IowaScaledEngineering/ckt-squeal/doc/squeal-bag-top.odt

Iowa Scaled Engineering, LLC

http://iascaled.com/

Iowa Scaled Engineering, LLC

http://iascaled.com/

Iowa Scaled Engineering, LLC

http://iascaled.com/

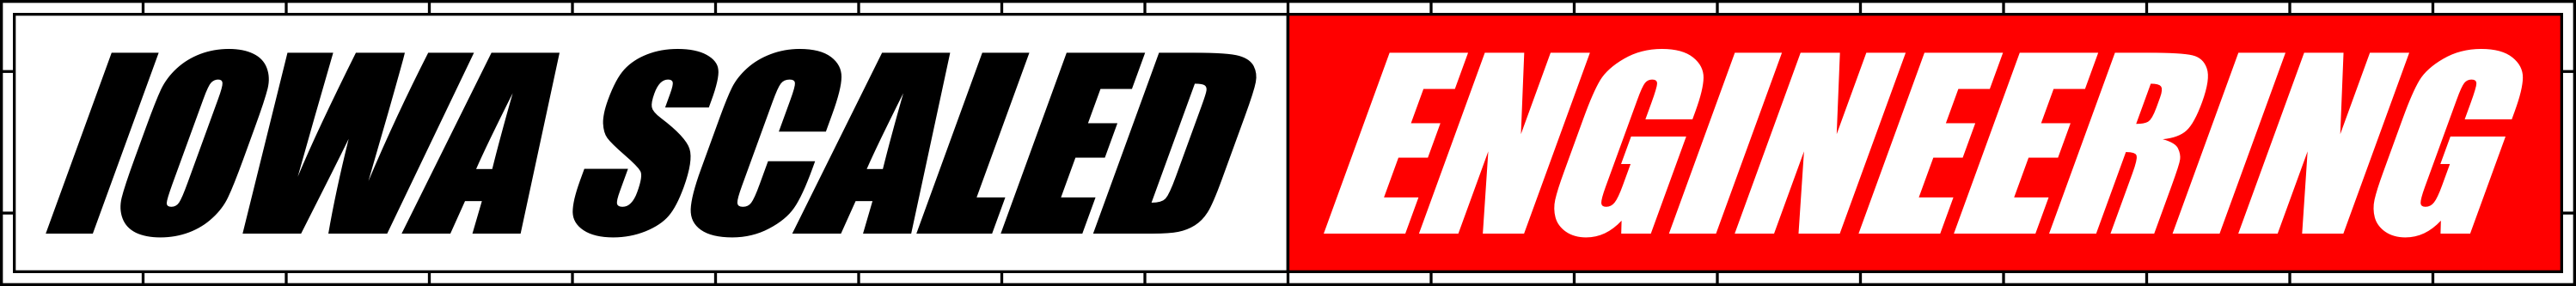
[picture p1: figure]

Low-Cost Sound Player

The CKT-SQUEAL is an inexpensive SD card sound player featuring 4 trigger inputs and reconfigurability via files on the SD card.

CKT-SQUEAL

4GB microSD Card

4GB microSD card for the CKT-SQUEAL sound player.

2” 4Ω Speaker

Speaker for the CKT-SQUEAL sound player.
