IowaScaledEngineering/ckt-squeal/doc/usermanual/ckt-squeal-manual.odt

CKT-SQUEAL v1 User Manual

# Features

- Integrated 725mW speaker driver and volume control
- Trigger inputs for four different groups of sounds
- User-loadable sounds using standard microSD cards and WAV files
- Flexible playback options:
  - Edge or level triggered
  - One-shot, random, or looping playback
  - Begin-middle-end mode
- Cost-effective sound playback for adding ambient sound effects to your layout

# Installation

### Power

The CKT-SQUEAL requires 8-14VDC power. Ripple or electrical noise on the input power may create hums, pops, or buzzing in the audio output, so be sure to use a clean power source. Do not exceed 14VDC or the device may be damaged.

### Inputs

Inputs are triggered by connecting them to the ground terminals provided between trigger inputs SW2 & SW3. The inputs are internally pulled up, so it's possible to trigger them with just a pushbutton or open-drain (aka open-collector) connection to ground.

Figure 1: Examples of input and output connections

Do not apply more than 3.3V to any of the input terminals or they will be damaged. If you want to trigger off another circuit with higher voltages, please use a CKT-MRISO2 to provide isolation.

### Outputs

The speaker outputs from the onboard power amplifier are designed for speakers with an impedance of 4Ω - 16Ω. Lower impedances will provide higher volumes, but will also consume additional power. We recommend 4Ω speakers for best performance. Output volume to the speaker can be adjusted with R9, the large thumbwheel potentiometer located near the speaker outputs.

Additionally, a line level output is provided for those wanting to use external amplification. The holes labeled “J8”, near the programming header and microprocessor, provide line level signals. The audio signal is on pin 1 (the square pad) and ground/shield is on the round pad.

### Diagnostic Lights

The CKT-SQUEAL comes with four indicator lights that show the current status and indicate any problems. Three status lights (D3-D5) are located near the edge of the board. A fourth power indicator (D2) is located next to the microSD card socket.

LED Color | If Solid... | If Blinking...
Red (D5) | Hardware error | SD card not inserted/recognized
Yellow (D4) | Player ready but idle | Reading SD card
Green (D3) | Audio is playing | n/a
Green (D2) | Power is on | Regulator is overheating because of hardware failure or excessive input voltage

# Audio Files and the MicroSD Card

The CKT-SQUEAL can take any microSD or microSDHC card up to 32GB that is formatted as FAT or FAT32 and supports SPI access modes. MicroSDXC cards will not work (generally cards greater than 64GB). However, given the small size of most sound files, even a 1GB card is far more than adequate.

While we have tested with industry-standard cards and strive to support any card that adheres to the standards, we can't guarantee that every brand and model will work - particularly those from the low-cost, no-name bargain vendors. We recommend Sandisk 4GB microSDHC cards for their reliability and compatibility.

The microSD card should have four directories (also known as folders) at the top level. They should be named event1, event2, event3, and event4. These correspond to the sounds that will play for inputs SW1-SW4. If you don't wish to use a given input, there's no need to create a directory/folder for that input.

The sound files you want to play for a given input should be placed into the eventN folder for that input. Sound files should be 16-bit mono WAV files with LPCM encoding. All standard sample rates up to 48kHz are supported. Files should have a suffix of “.wav”.

If you don't already have a favorite audio editing program, we recommend Audacity. It's easy to use, free, open source, and works on Windows, Mac, and Linux. You can download the latest version from http://audacity.sourceforge.net

# Configuring Playback Modes

There are five basic playback modes, as shown in Table 1, which lend themselves to differing scenarios. The operating mode for each input is configured by adding files to the eventN directory. The files do not need to contain anything specific - the behavior is keyed to their name.

Begin-Middle-End (BME) mode is special. It is specifically designed for situations where you want an initial sound, a repeating middle sound until the input is no longer active, and then an end sound. Using good audio editing, it is possible to assemble clips that stack up seamlessly.

An example of a BME mode application would be a train crossing a diamond. You would set up an occupancy detector, such as a CKT-IRSENSE, near the diamond. When it first got a detection, you'd want to play the locomotives passing, then repeat the clatter of wheels as long as a train was over the sensor, and finally play a fading away sound. For this, you would want BME mode. The eventN directory should contain four files - bme.opt to set up BME mode, and then begin.wav, middle.wav, and end.wav. The file begin.wav will play first, then middle.wav will loop continuously if the input is still low, and end.wav will finally play when input goes high again.

Table 1. Playback Modes

Mode | Option Files | Playback Starts | Playback Stops | Repeats?
One Shot | (none - default) | SWn goes low | Track completes | N
Repeating | retrig.opt | SWn goes low | Track completes | Y - same track
Random Repeating | rndrtrg.opt | SWn goes low | Track completes | Y - random track
Level Triggered | lvltrig.opt | SWn goes low | SWn goes high | Y - same track
Level Random | lvltrig.opt rndrtrg.opt | SWn goes low | SWn goes high | Y - random track
Begin-Middle-End | bme.opt | SWn goes low | SWn goes high and end.wav finishes | Y - middle.wav

# Open Design

Iowa Scaled Engineering is committed to creating open designs that users are free to build, modify, adapt, improve, and share with others.

### Hardware

The design of the CKT-SQUEAL hardware is open source hardware, and is made available under the terms of the Creative Commons Attribution-Share Alike v3.0 license, a copy of which is available from: http://creativecommons.org/licenses/by-sa/3.0/

Design files can be found on the Iowa Scaled Engineering website:

http://www.iascaled.com/store/CKT-SQUEAL

### Firmware

The official Iowa Scaled Engineering firmware for the CKT-SQUEAL is free software: you can redistribute it and/or modify it under the terms of the GNU General Public License as published by the Free Software Foundation, either version 3 of the License, or (at your option) any later version. A copy of the GNU GPL can be found at: http://www.gnu.org/licenses/gpl.html

New firmware can be flashed into the CKT-SQUEAL through the standard 6-pin AVR ISP header provided on the board.

Stable releases of firmware and source code can be found on the Iowa Scaled Engineering website: http://www.iascaled.com/store/CKT-SQUEAL
