IowaScaledEngineering/ckt-squeal/doc/usermanual/ckt-squeal.png

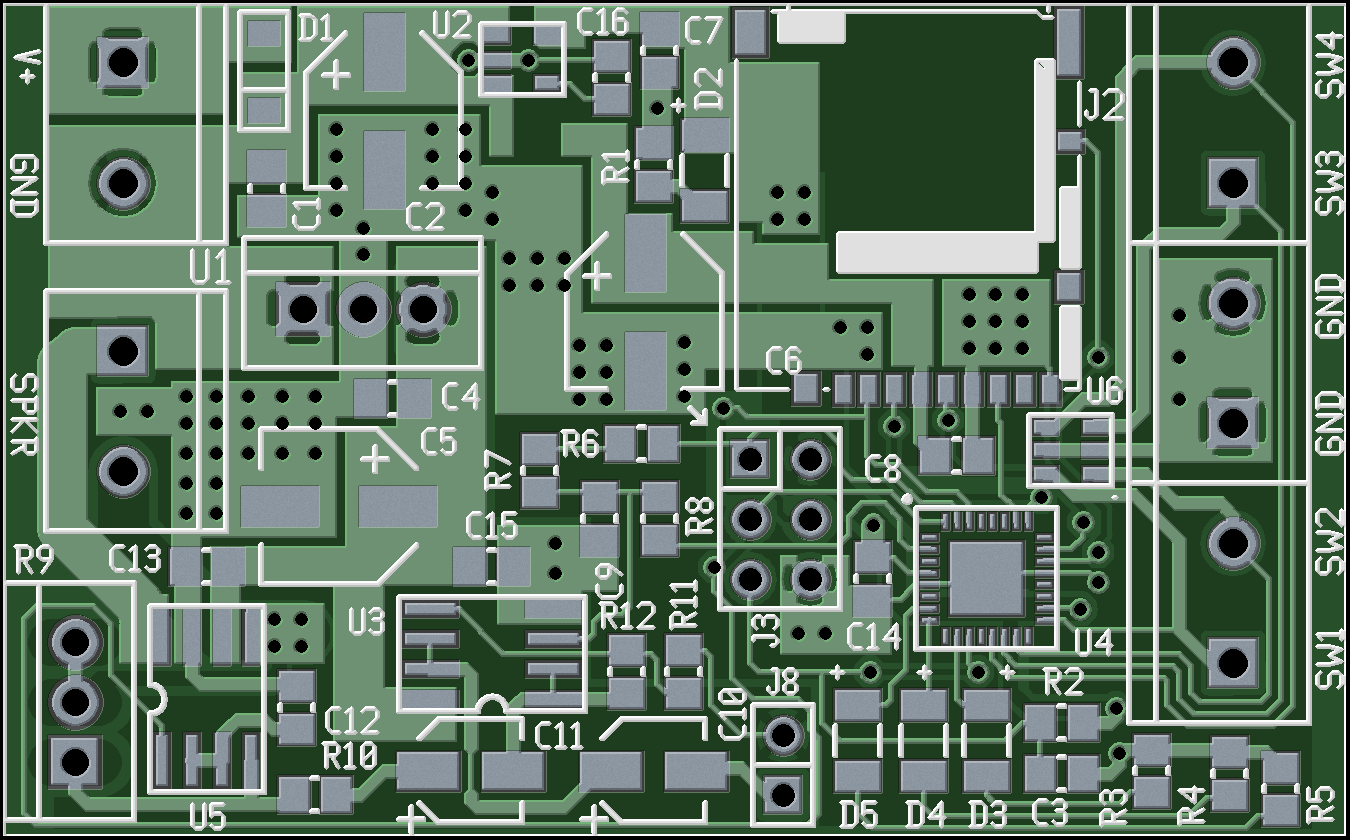
doc/usermanual/ckt-squeal.png
