IowaScaledEngineering/ckt-squeal/doc/usermanual/wiring1.png

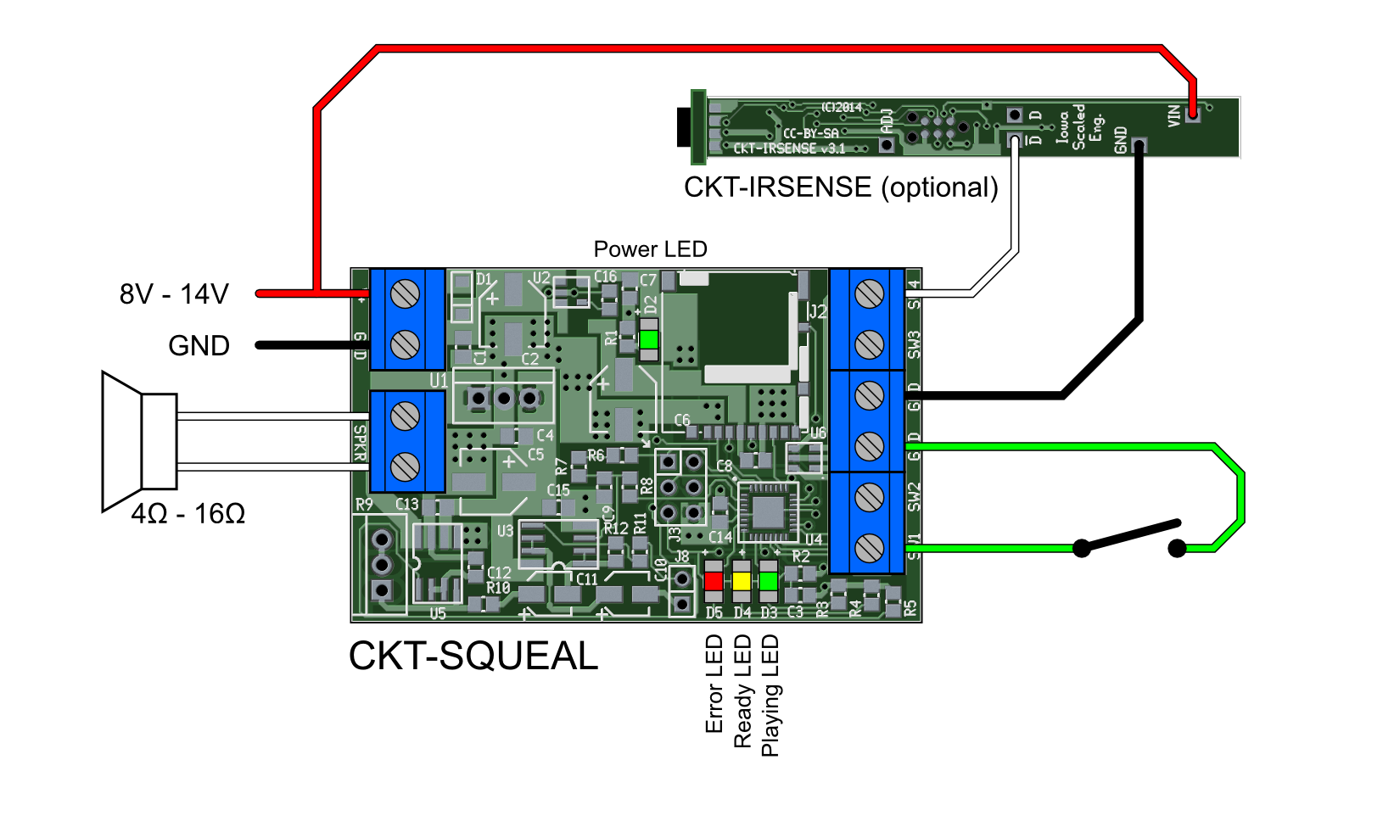
doc/usermanual/wiring1.png
