IowaScaledEngineering/ckt-squeal/pg/ckt-squeal-v1.1-r935/ckt-squeal.pdf

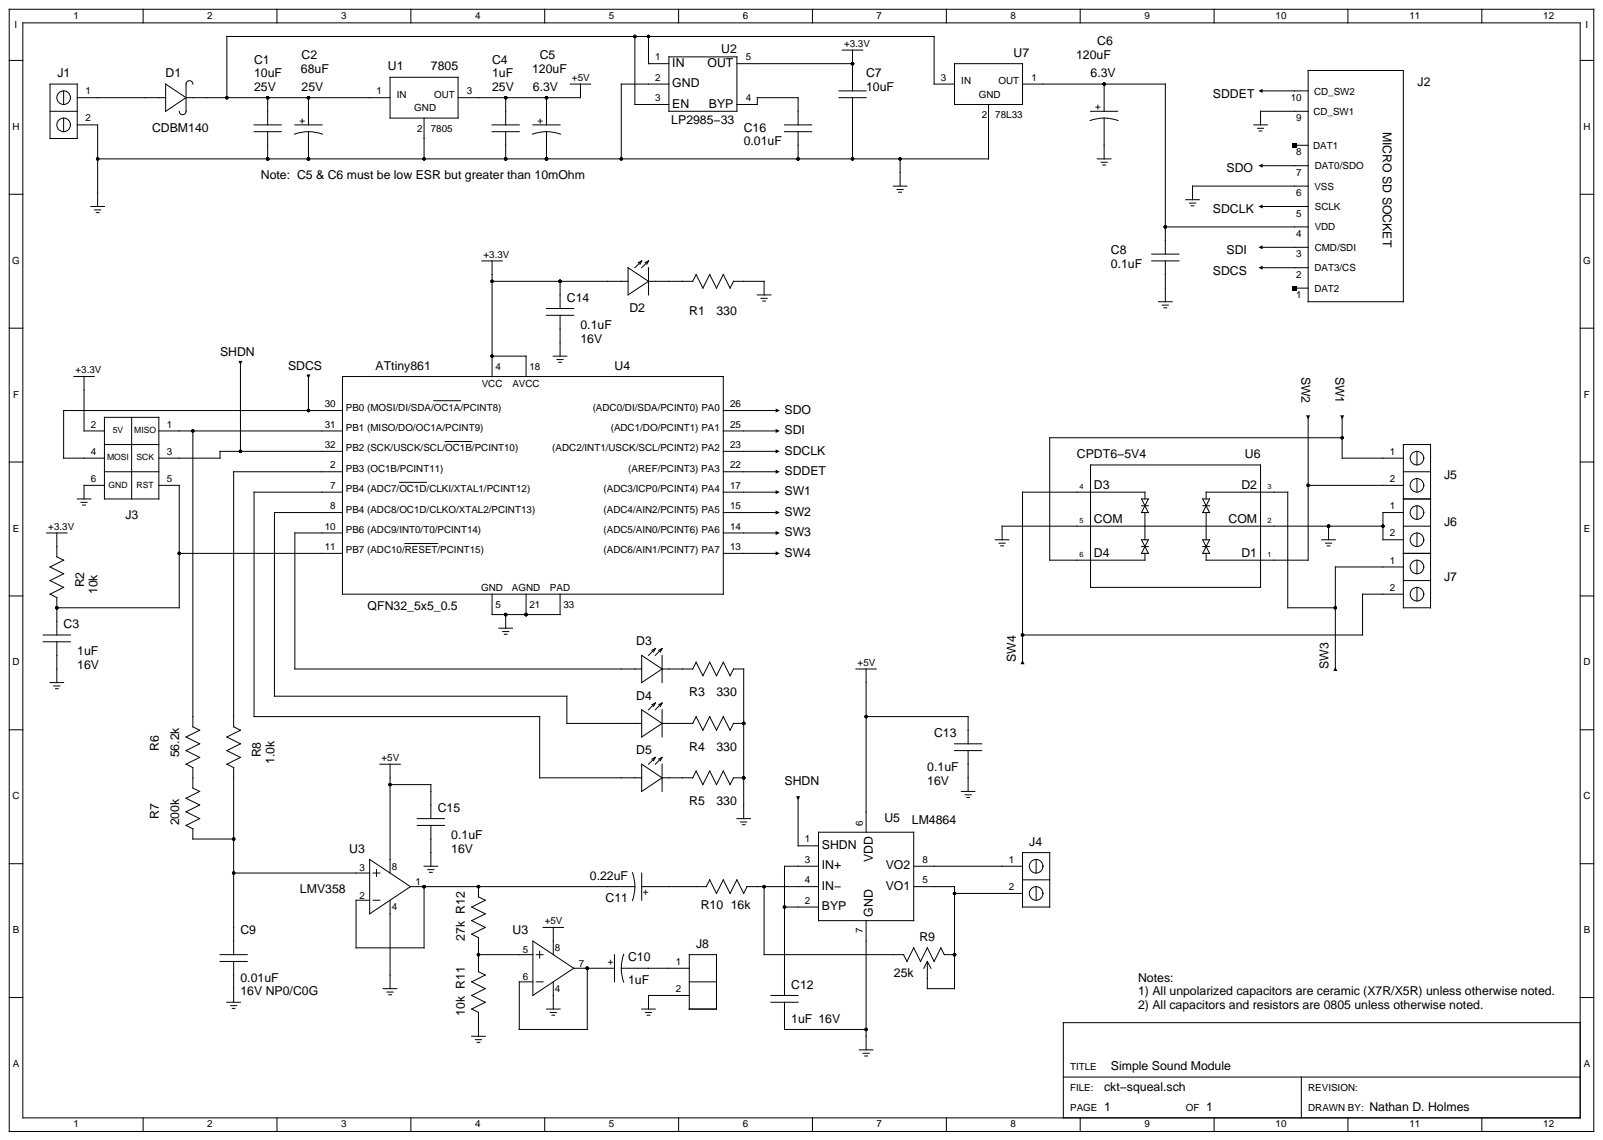
[picture p11: page 1]

Note: C5 & C6 must be low ESR but greater than 10mOhm

5V | MISO

MOSI | SCK

Notes:
1) All unpolarized capacitors are ceramic (X7R/X5R) unless otherwise noted.
2) All capacitors and resistors are 0805 unless otherwise noted.
