IowaScaledEngineering/ckt-squeal/pg/ckt-squeal-v1.0-r876/ckt-squeal-pcb.pdf

# ckt-squeal.pcb

# 1. Table of Contents (This Page) Created on Mon May 26 21:52:58 2014

# 2. component 3. solder 4. outline 5. plated-drill 6. componentmask 7. soldermask 8. topsilk 9. bottomsilk 10. toppaste 11. topassembly 12. bottomassembly 13. fab

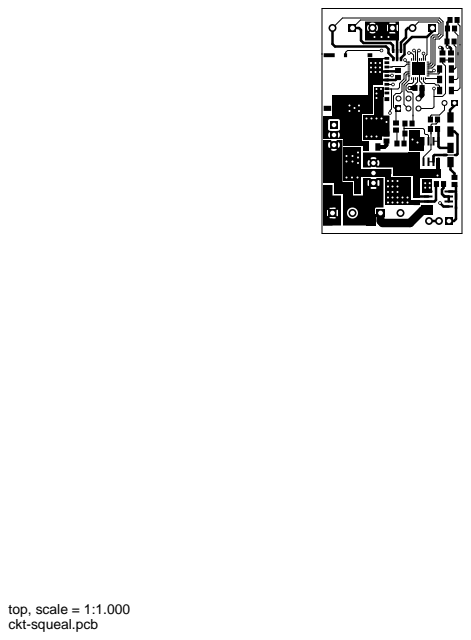
[picture p12: page 2]
top, scale = 1:1.000

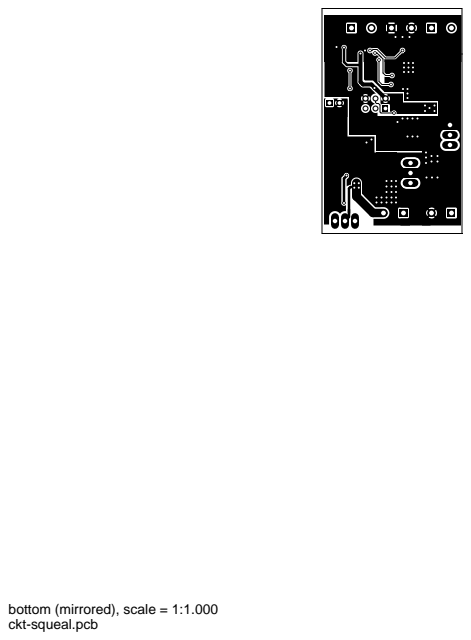
[picture p13: page 3]

bottom (mirrored), scale = 1:1.000

outline, scale = 1:1.000

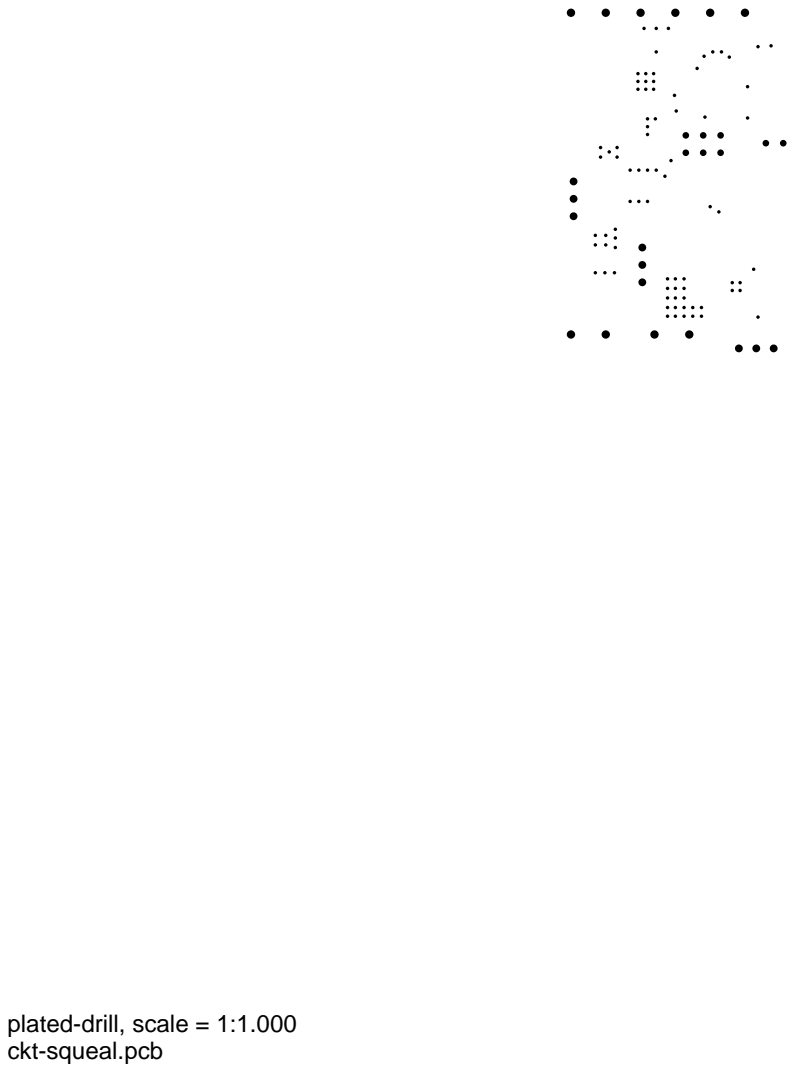
[picture p14: page 5]

plated-drill, scale = 1:1.000

topmask, scale = 1:1.000 bottommask (mirrored), scale = 1:1.000

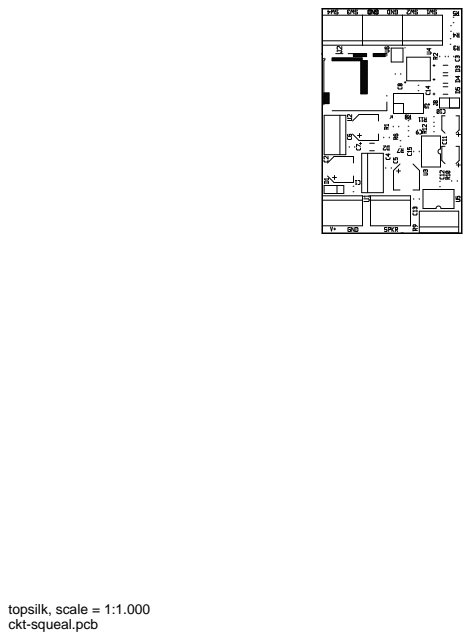
[picture p15: page 8]
topsilk, scale = 1:1.000

bottomsilk (mirrored), scale = 1:1.000

toppaste, scale = 1:1.000

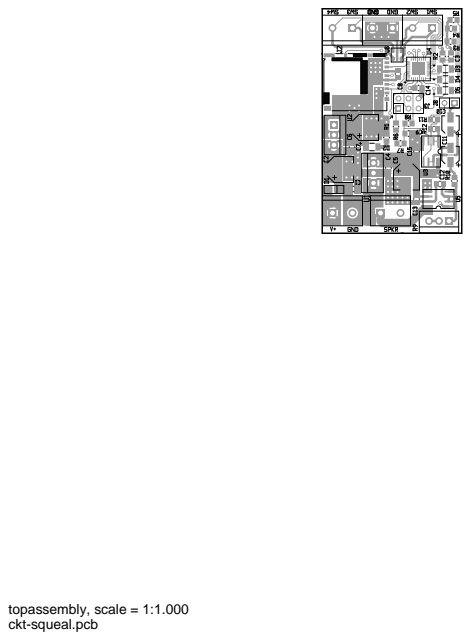
[picture p16: page 11]
topassembly, scale = 1:1.000

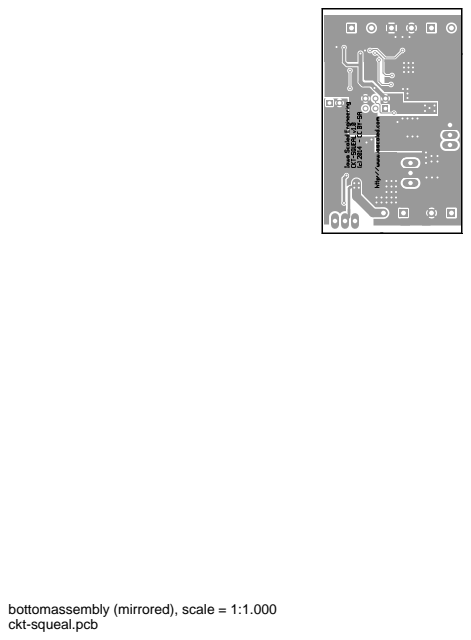
[picture p17: page 12]

bottomassembly (mirrored), scale = 1:1.000

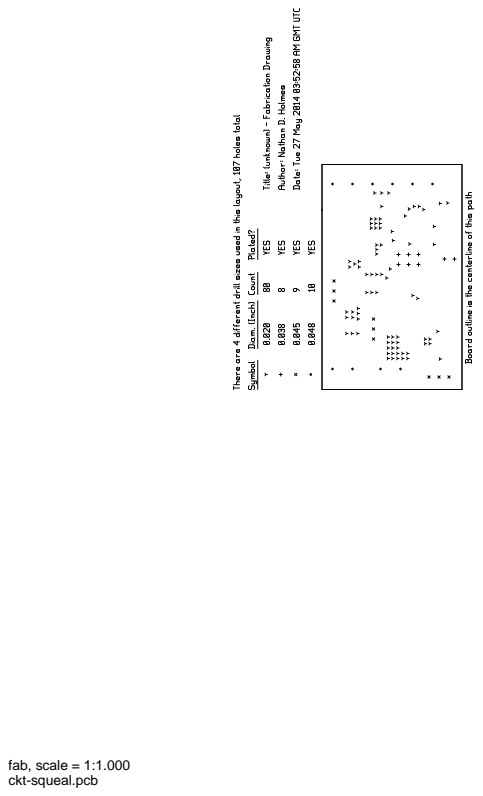
[picture p18: page 13]
fab, scale = 1:1.000
