IowaScaledEngineering/ckt-squeal/sim/filter.asc

C1: cap; 10n
C11: cap; 10n
C12: cap; 10n
C13: cap; 1n
R1: res; 1k
R11: res; 1.028k
R12: res; 1.666k
R13: res; 2.944k
U1: opamp
U2: opamp
VIN: voltage; 1.65; AC 1 0
Named nets: 0, VOUT_ORIG, VOUT_NEW
.ac dec 10 10 10e6
.lib opamp.sub
