IowaScaledEngineering/ckt-squeal/(list of files, drawings)

Other design files:
pcb/ckt-squeal.pcb
