IowaScaledEngineering/ckt-squeal/(commit log)

2014-04-06 Schematic, first cut, missing stuff
    [ckt-squeal.sch]
2014-04-06 A bit of rearranging to give me more headroom on the amps
    [ckt-squeal.sch]
2014-04-06 More edits, more fixes now with more sleep
    [ckt-squeal.sch]
2014-04-06 Cap value change
    [ckt-squeal.sch]
2014-05-20 Morning changes
    [ckt-squeal.sch]
2014-05-20 More changes - maybe done-ish?
    [ckt-squeal.sch]
2014-05-20 Finalize footprints
    [ckt-squeal.sch]
2014-05-20 More footprint changes
    [ckt-squeal.sch]
2014-05-21 More changes to schematic, add pcb directory
    [ckt-squeal.sch]
2014-05-21 More changes
    [ckt-squeal.sch]
2014-05-21 Update resistor values
    [ckt-squeal.sch]
2014-05-21 Move volume pot to feedback path
    [ckt-squeal.sch]
2014-05-22 Changes updating squealer schematic
    [ckt-squeal.sch]
2014-05-22 Forgot footprint on U2
    [ckt-squeal.sch]
2014-05-22 Add initial round of PCB
    [ckt-squeal.pcb]
2014-05-22 Fix the problem where pin 2 thinks it's part of the ground net.
2014-05-22 Start of squealer pcb
    [ckt-squeal.pcb]
2014-05-23 Layout mostly complete, cleaning up details
    [ckt-squeal.pcb]
2014-05-23 Fix a few issues
    [ckt-squeal.pcb]
2014-05-23 Add back text and outline
    [ckt-squeal.pcb]
2014-05-23 More fixes
    [ckt-squeal.pcb]
2014-05-23 Add arrow to header
    [ckt-squeal.pcb]
2014-05-23 Fix for labels
    [ckt-squeal.pcb]
2014-05-23 Update schematic
    [ckt-squeal.sch]
2014-05-23 More fixes - fix power on sd card
    [ckt-squeal.pcb, ckt-squeal.sch]
2014-05-23 More fixing
    [ckt-squeal.pcb]
2014-05-23 Swapped in new avr symbol
    [ckt-squeal.sch]
2014-05-25 Fixed text alignment issues
    [ckt-squeal.sch]
2014-05-27 PG out the squealer - this is what was sent to oshpark
    [ckt-squeal.bottom.gbr, ckt-squeal.bottommask.gbr, ckt-squeal.bottompaste.gbr, ckt-squeal.bottomsilk.gbr, ckt-squeal.fab.gbr, ckt-squeal.outline.gbr, ckt-squeal.top.gbr, ckt-squeal.topmask.gbr]
2014-06-12 Fix for shutdown pin being tied to always shut down Oops Now connected to AVR SCLK line
    [ckt-squeal.pcb, ckt-squeal.sch]
2014-06-12 This is the version that was actually on my machine and running the prototype
2014-06-13 Rename a few things, fix more error lights
    [ckt-squeal.c]
2014-06-13 Make the thing skip empty events
    [ckt-squeal.c]
2014-06-13 Move centering of the PWM DAC to a single spot
2014-06-18 Modified for independent regulators
    [ckt-squeal.pcb, ckt-squeal.sch]
2014-06-19 Modified to have 78l33 SOT89 regulator for SD card
    [ckt-squeal.pcb, ckt-squeal.sch]
2014-06-20 Fixed polarity of audio amp shdn line
    [ckt-squeal.c]
2014-06-20 Add new 1.1 version pg with separate 3.3 regulators
    [ckt-squeal.bottom.gbr, ckt-squeal.bottommask.gbr, ckt-squeal.bottompaste.gbr, ckt-squeal.bottomsilk.gbr, ckt-squeal.fab.gbr, ckt-squeal.outline.gbr, ckt-squeal.top.gbr, ckt-squeal.topmask.gbr]
2014-06-22 Changed opamp to MCP part
    [ckt-squeal.sch]
2014-06-22 Changed C10 to 0.22uF
    [ckt-squeal.sch]
2014-07-09 Updated documentation Added I2C-IRSENSE files
2014-08-04 Change input voltage range
2014-08-17 Something changed... maybe forgot to check in before STL RPM?
2014-10-15 Fixed LED symbol
2014-12-06 Fixes to make non-BME modes work right again and cleanup that bought us codespace
    [ckt-squeal.c]
2014-12-06 Fix one shot mode
    [ckt-squeal.c]
2014-12-15 Added 48kHz sample rate
2015-01-06 Fixes for lockup on missing directories, possible lockup after playback, and unneeded delay
    [ckt-squeal.c]
2015-01-17 Fix issue with not ignoring RIFF chunks we don't understand Fix issue with not ignoring files that begin with '.' Fix issue with not needing exact matches for option file names
    [ckt-squeal.c]
2015-03-11 Changed R9 from 25k to 50k
    [ckt-squeal.sch]
2016-01-14 v1.2 edits 0805 LEDs, rpack, new CDBM140 footprint, stab-in prog header
    [ckt-squeal.pcb, ckt-squeal.sch]
